altunsumerve/esp32-mini-antenna-analyzer/docs/img/olcumler/01-iki-halka-ilk-tarama.png

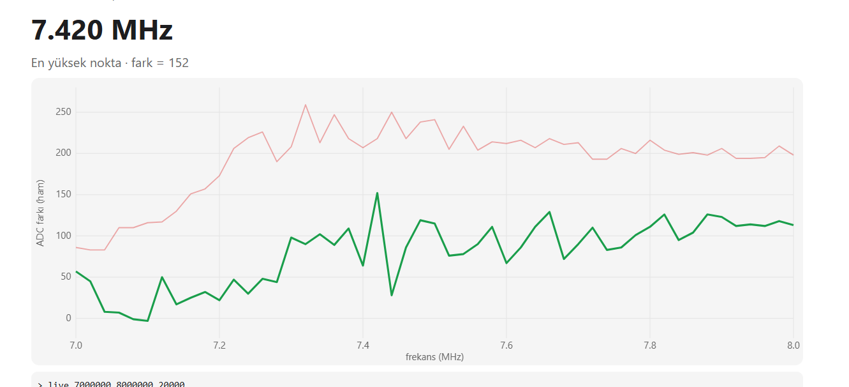
docs/img/olcumler/01-iki-halka-ilk-tarama.png
