altunsumerve/esp32-mini-antenna-analyzer/docs/img/olcumler/02-anahtar-kapali-tarama.png

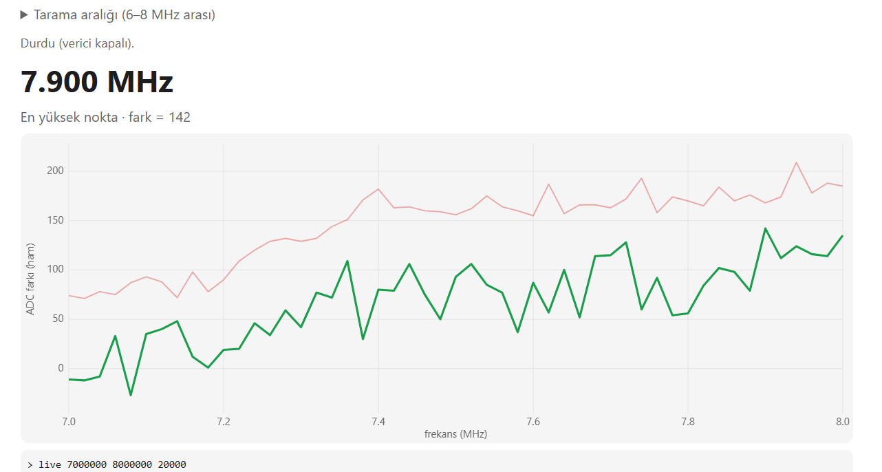
docs/img/olcumler/02-anahtar-kapali-tarama.png
