altunsumerve/esp32-mini-antenna-analyzer/docs/img/olcumler/03-ince-tarama-5khz.png

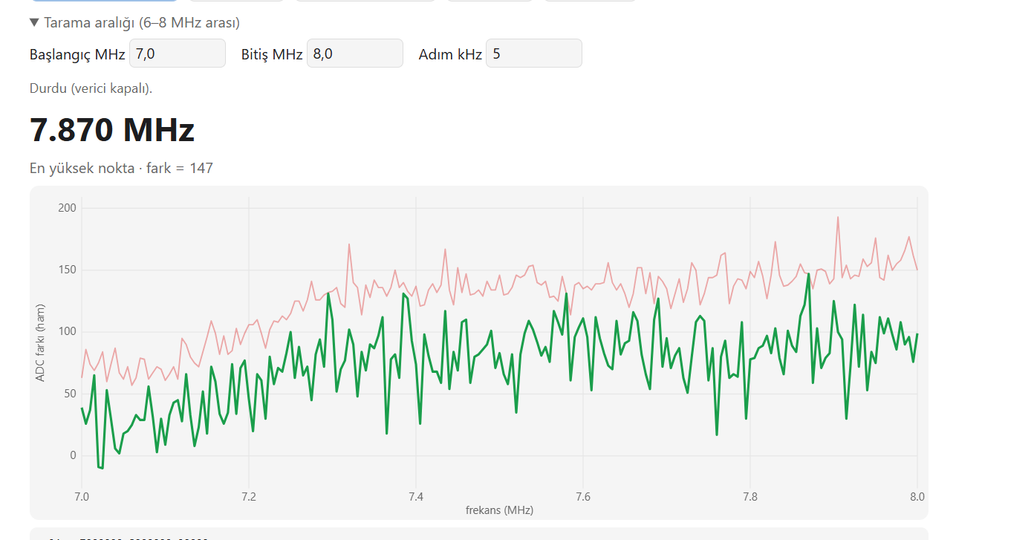
docs/img/olcumler/03-ince-tarama-5khz.png
