altunsumerve/esp32-mini-antenna-analyzer/docs/img/olcumler/04-referans-kaydedildi.png

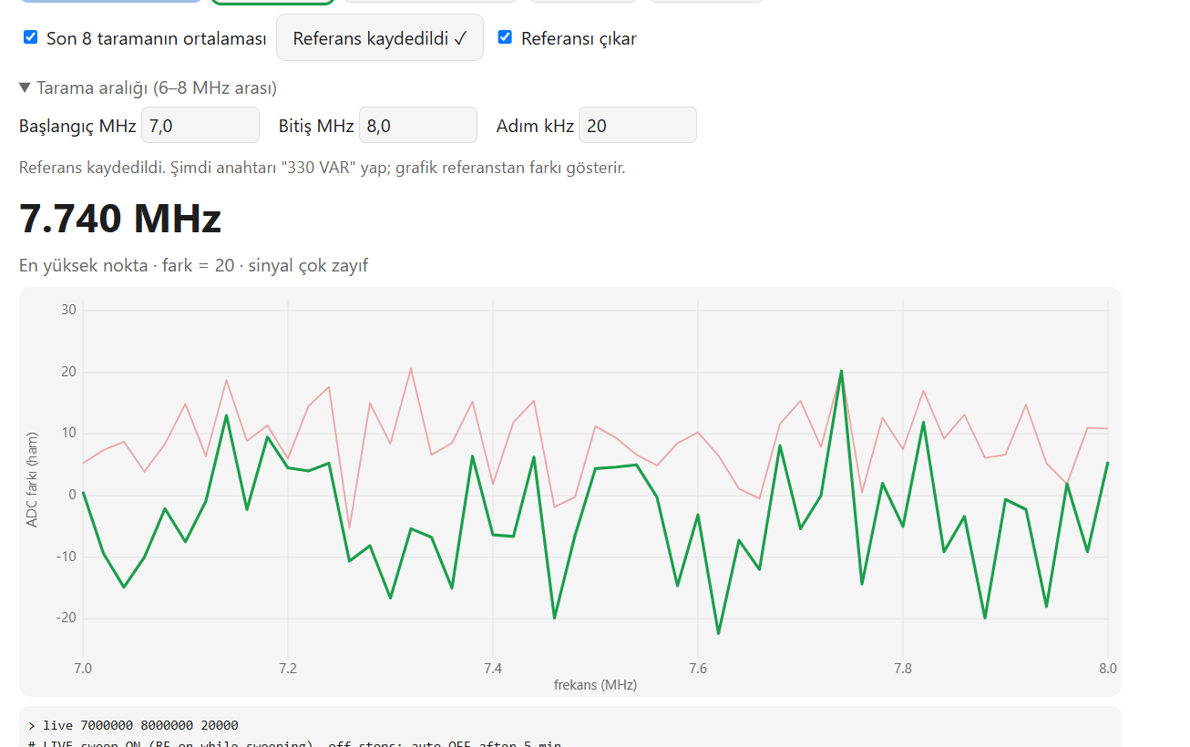
docs/img/olcumler/04-referans-kaydedildi.png
