altunsumerve/esp32-mini-antenna-analyzer/docs/img/olcumler/05-referans-cikarildi-duz.png

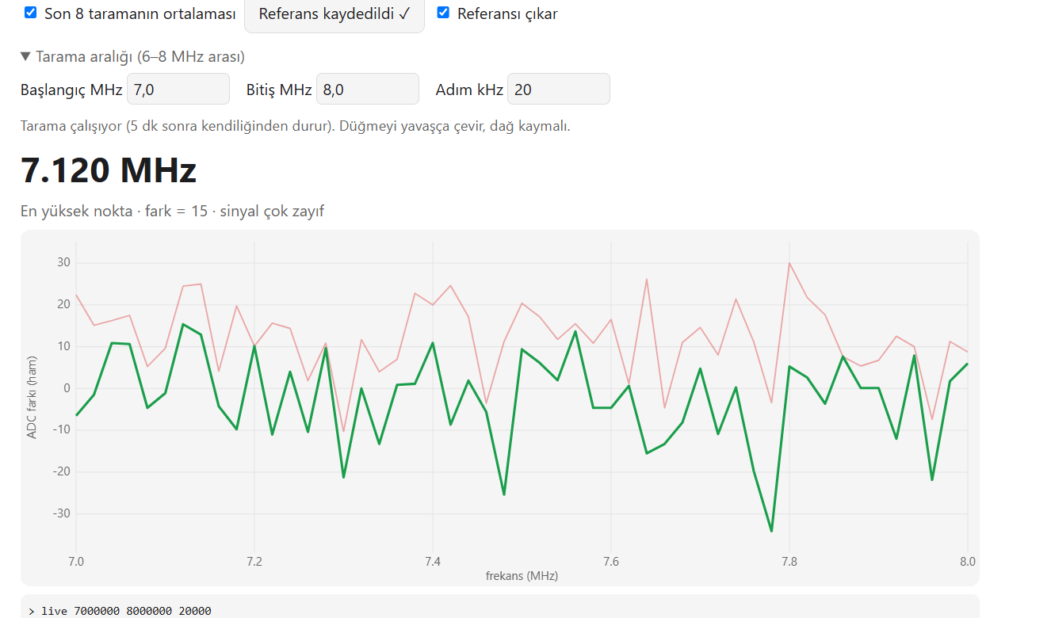
docs/img/olcumler/05-referans-cikarildi-duz.png
