altunsumerve/esp32-mini-antenna-analyzer/docs/img/olcumler/06-anahtar-baglandi.png

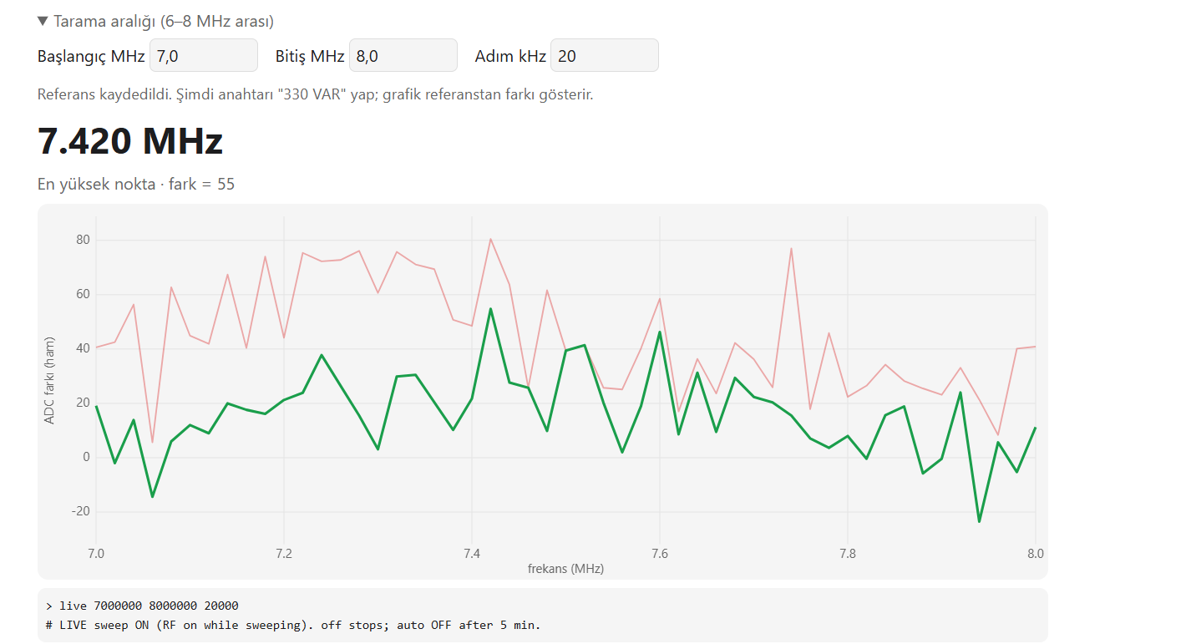
docs/img/olcumler/06-anahtar-baglandi.png
