altunsumerve/esp32-mini-antenna-analyzer/docs/img/olcumler/09-dugme-cevrildi-7-14MHz.png

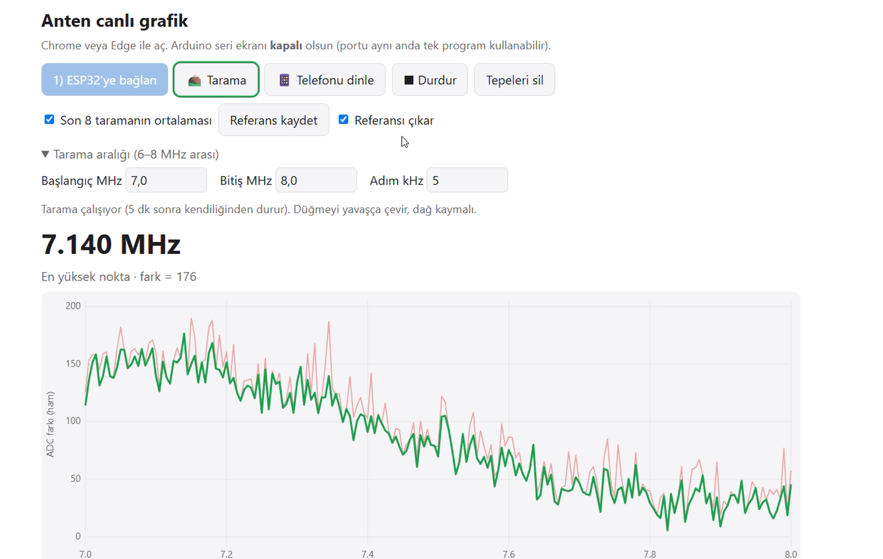
docs/img/olcumler/09-dugme-cevrildi-7-14MHz.png
